PrometeoZgz/Nodo_ESP12/hardware_001/Listado componentes prometeo_001.ods

Sheet: Componentes_comunes
Part | Value | Device | Package | Description | MF | MPN | OC_FARNELL | OC_NEWARK
C1 | 100uF | CPOL-USSMCC | SMC_C | POLARIZED CAPACITOR, American symbol
C2 | 100nF | C-EUC0402 | C0402 | CAPACITOR, European symbol
C3 | 10uF | C-EUC0805 | C0805 | CAPACITOR, European symbol
C4 | 10uF | C-EUC0805 | C0805 | CAPACITOR, European symbol
C5 | 10uF | C-EUC0805 | C0805 | CAPACITOR, European symbol
C6 | 100nF | C-EUC0402 | C0402 | CAPACITOR, European symbol
C7 | 100uF | CPOL-USSMCC | SMC_C | POLARIZED CAPACITOR, American symbol
C8 | 100nF | C-EUC0402 | C0402 | CAPACITOR, European symbol
C9 | 10uF | C-EUC0805 | C0805 | CAPACITOR, European symbol
F1 |  | FUSE | FUSE | FUSE
IC2 | MAX11609 | MAX11609 | QSOP16 | 2.7V to 5.5V, Low-Power, 4-/12-Channel 2-Wire Serial 8-Bit ADCs
JP1 |  | PINHD-1X06_2.00 | 1X06M | PIN HEADER
JP2 |  | PINHD-1X2 | 1X02 | PIN HEADER
R1 | 470K | R-EU_R0402 | R0402 | RESISTOR, European symbol
R2 | 10K | R-EU_R0402 | R0402 | RESISTOR, European symbol
R3 | 10K | R-EU_R0402 | R0402 | RESISTOR, European symbol
R4 | 10K | R-EU_R0402 | R0402 | RESISTOR, European symbol
R5 | 10K | R-EU_R0402 | R0402 | RESISTOR, European symbol
R6 | 470K | R-EU_R0402 | R0402 | RESISTOR, European symbol
R7 | Por definir | R-EU_R0402 | R0402 | RESISTOR, European symbol
R8 | 470K | R-EU_R0402 | R0402 | RESISTOR, European symbol
R9 | 470K | R-EU_R0402 | R0402 | RESISTOR, European symbol
R10 | 470K | R-EU_R0402 | R0402 | RESISTOR, European symbol
R11 | 470K | R-EU_R0402 | R0402 | RESISTOR, European symbol
R12 | 18R | R-EU_R1206 | R1206 | RESISTOR, European symbol
R13 | 18R | R-EU_0204/7 | 0204/7 | RESISTOR, European symbol
R14 | Por definir | R-EU_R0402 | R0402 | RESISTOR, European symbol
R15 | 1K | R-EU_R0402 | R0402 | RESISTOR, European symbol
R17 | 1K | R-EU_R0402 | R0402 | RESISTOR, European symbol
R18 | 1K | R-EU_R0402 | R0402 | RESISTOR, European symbol
R19 | 470K | R-EU_R0402 | R0402 | RESISTOR, European symbol
R20 | 470K | R-EU_R0402 | R0402 | RESISTOR, European symbol
R21 | 18R | R-EU_R1206 | R1206 | RESISTOR, European symbol
R22 | 18R | R-EU_0204/7 | 0204/7 | RESISTOR, European symbol
R23 | 1K | R-EU_R0402 | R0402 | RESISTOR, European symbol
R24 | 470K | R-EU_R0402 | R0402 | RESISTOR, European symbol
R25 | 470K | R-EU_R0402 | R0402 | RESISTOR, European symbol
R26 | 18R | R-EU_R1206 | R1206 | RESISTOR, European symbol
R27 | 18R | R-EU_0204/7 | 0204/7 | RESISTOR, European symbol
R28 | 1K | R-EU_R0402 | R0402 | RESISTOR, European symbol
R29 | 1K | R-EU_R0402 | R0402 | RESISTOR, European symbol
R30 | 1K | R-EU_R0402 | R0402 | RESISTOR, European symbol
R31 | 210K | R-EU_R1206 | R1206 | RESISTOR, European symbol
R32 | 210K | R-EU_R1206 | R1206 | RESISTOR, European symbol
U$4 | KSR221GKSS221G_PACKAGE | KSR221GKSS221G_PACKAGE | SMD1 |  | C&K Components | KSR221G LFS | 1201421
U$6 | TRAFO_AISLAMIENTOBOURNS_SM-LP-5001 | TRAFO_AISLAMIENTOBOURNS_SM-LP-5001 | SM-LP-5001
U$7 | TRAFO_AISLAMIENTOETAL_P3191 | TRAFO_AISLAMIENTOETAL_P3191 | P3191
U1 | ESP12EPADS_SMD | ESP12EPADS_SMD | ESP12E_SMD
X1 | 1503_02 | 1503_02 | 1503_02 | Jack connectors according to JISC 6560, 3.5 mm |  |  | 1216979 | unknown
X2 | 1503_02 | 1503_02 | 1503_02 | Jack connectors according to JISC 6560, 3.5 mm |  |  | 1216979 | unknown
X3 | 1503_02 | 1503_02 | 1503_02 | Jack connectors according to JISC 6560, 3.5 mm |  |  | 1216979 | unknown
X4 | MKDSN1,5/2-5,08 | MKDSN1,5/2-5,08 | MKDSN1,5/2-5,08 | MKDSN 1,5/ 2-5,08 Printklemme
Entre U$6 y U$7 elegir sólo uno para montar
R7 y R14 se deberán fijar según pruebas
R12, R13, R21, R22, R26 y R27 deberán de ser de precisión a colocar según la pinza que se vaya a utilizar. Se han puesto dos huellas por resistencia, utilizar sólo una.
Tanto de las hojas marcadas como "A_" y "S_" se debe escoger una opción.
Las "A_" se refieren al tipo de alimentación a usar
Las "S_" se refieren a como alimentar la parte de los sensores.
Si se observan reseteos o funcionamientos extraños cuando el ESP está transmitiendo aumentar la capacidad de C7 a 470uF

Sheet: A_USB+batería
Part | Value | Device | Package | Description | MF | MPN | OC_FARNELL | OC_NEWARK
IC1 | STLQ015_SOT23-5L | STLQ015_SOT23-5L | SOT23-5L | ST => STLQ015XG33R
U$2 | DF13-3P-1.25H | DF13-3P-1.25H | DF13A-3P-1.25H | DF13-3P | Hirose | DF13-3P-1.25H
U$3 | MCP73811 | MCP73811 | SOT23-5L
U$10 | USBMICRO_USB_CONEXCON | USBMICRO_USB_CONEXCON | MICROUSB_CONEXCON_5632 | Conexcon => 5632-16052E | Conexcon | 5632-16052E

Sheet: A_Trafo_5V_+_batería
Part | Value | Device | Package | Description | MF | MPN | OC_FARNELL | OC_NEWARK
IC1 | STLQ015_SOT23-5L | STLQ015_SOT23-5L | SOT23-5L | ST => STLQ015XG33R
U$2 | DF13-3P-1.25H | DF13-3P-1.25H | DF13A-3P-1.25H | DF13-3P | Hirose | DF13-3P-1.25H
U$3 | MCP73811 | MCP73811 | SOT23-5L
U$5 | VTX-214-001-105 | PSU_VTX | PSU_VTX

Sheet: A_Trafo_3V3
Part | Value | Device | Package | Description | MF | MPN | OC_FARNELL | OC_NEWARK
U$5 | VTX-214-001-103 | PSU_VTX | PSU_VTX
Soldar el jumper SJ3

Sheet: S_Referencia_externa_3V3
Part | Value | Device | Package | Description | MF | MPN | OC_FARNELL | OC_NEWARK
Soldar SJ1 y SJ2.
El ADC deberá configurarse para utilizar la referencia externa

Sheet: S_Referencia_externa_3V
Part | Value | Device | Package | Description | MF | MPN | OC_FARNELL | OC_NEWARK
U$1 | MCP1501-30 | MCP1501 | SOT23-6
Soldar SJ1.
El ADC deberá configurarse para utilizar la referencia externa

Sheet: S_Referencia_interna
Part | Value | Device | Package | Description | MF | MPN | OC_FARNELL | OC_NEWARK
U$1 | MCP1501-20 | MCP1501 | SOT23-6
El ADC deberá configurarse para utilizar la referencia interna
