PrometeoZgz/Nodo_ESP12/hardware_002_plated/prometeo_002_plated_signals.pdf

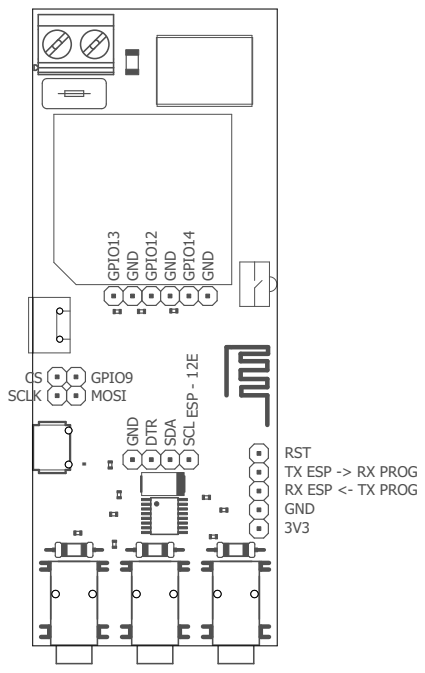
[picture p1: page 1]

ESP - 12E . 3V3 GND RST RX ESP <- TX PROG TX ESP -> RX PROG GND GND GND GPIO13 GPIO12 GPIO14 GND DTR SDA SCL GPIO9 MOSI CS SCLK
