PrometeoZgz/Nodo_ESP12/hardware_002_plated/prometeo_002_plated.brd

## EAGLE design hardware_002_plated/prometeo_002_plated.brd (2018-01-17)

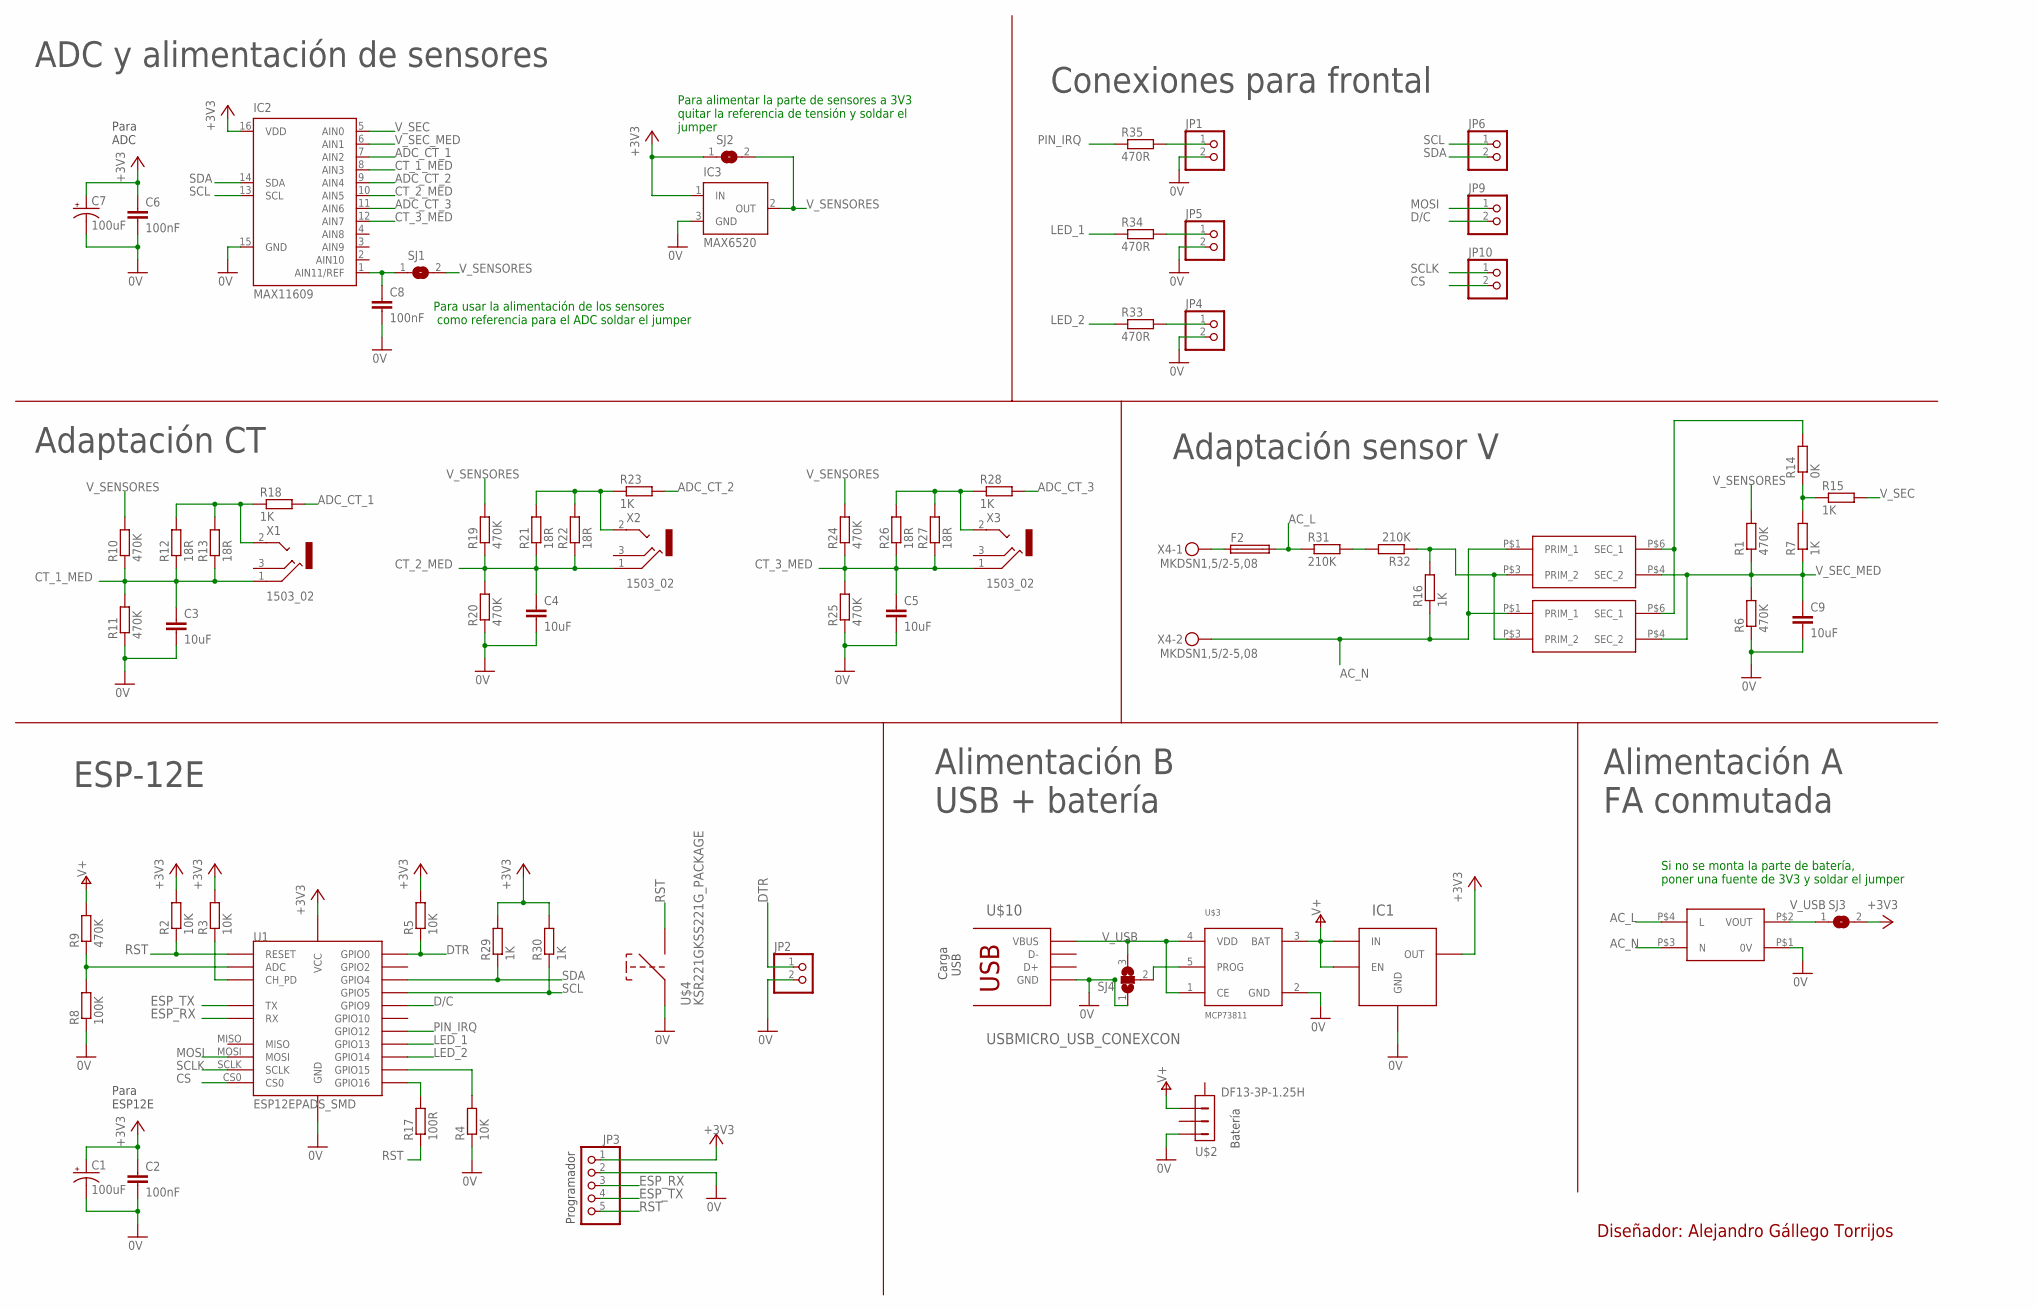
[picture p2: schematic prometeo_002_plated.sch]

Parts:
C1, C7: 100uF; SMC_C
C2, C6, C8: 100nF; C0402
C3, C4, C5, C9: 10uF; C0805
F2: MST 315MA 250V; TE5
IC1: STLQ015_SOT23-5L; SOT23-5L
IC2: MAX11609; QSOP16
IC3: MAX6520; SOT23
JP1, JP2, JP4, JP5, JP6, JP9, JP10: PINHD-1X2/CIRC; 1X02/CIRC
JP3: PINHD-1X5CIRC; 1X05/CIRC
R1, R6, R9, R10, R11, R19, R20, R24, R25: 470K; R0402
R2, R3, R4, R5: 10K; R0402
R7, R15, R18, R23, R28, R29, R30: 1K; R0402
R8: 100K; R0402
R12, R21, R26: 18R; R1206
R13, R22, R27: 18R; 0204/7
R14: 0K; R0402
R16: 1K; R1206
R17: 100R; R0402
R31, R32: 210K; R1206
R33, R34, R35: 470R; R0402
SJ1, SJ2, SJ3: SJ
SJ4: SJ2W; SJ_2
U1: ESP12EPADS_SMD; ESP12E_SMD
U$2: DF13-3P-1.25H; DF13A-3P-1.25H
U$3: MCP73811; SOT23-5L
U$4: KSR221GKSS221G_PACKAGE; SMD1
U$5: PSU_VTX
U$6: TRAFO_AISLAMIENTOBOURNS_SM-LP-5001; SM-LP-5001
U$7: TRAFO_AISLAMIENTOETAL_P3191; P3191
U$10: USBMICRO_USB_CONEXCON; MICROUSB_CONEXCON_5632
X1, X2, X3: 1503_02
X4: MKDSN1,5/2-5,08

Connections:
0V: C1.-, C2.2, C3.2, C4.2, C5.2, C6.2, C7.-, C8.2, C9.2, IC1.2 (GND), IC2.15 (GND), IC3.3 (GND), JP1.2, JP2.2, JP3.2, JP4.2, JP5.2, R4.1, R6.1, R8.1, R11.1, R20.1, R25.1, SJ4.1, U1.GND, U$2.P$1 (1), U$3.2 (GND), U$4.P$1, U$5.P$1 (0V), U$10.GND, U$10.GND1 (GND), U$10.GND2 (GND), U$10.P$8 (GND), U$10.P$9 (GND)
+3V3: C1.+, C2.1, C6.1, C7.+, IC1.5 (OUT), IC2.16 (VDD), IC3.1 (IN), JP3.1, R2.2, R3.2, R5.2, R29.2, R30.2, SJ2.1, SJ3.2, U1.VCC
AC_L: F2.2, R31.1, U$5.P$4 (L)
AC_N: R16.1, U$5.P$3 (N), U$6.P$1 (PRIM_1), U$7.P$1 (PRIM_1), X4.2
ADC_CT_1: IC2.7 (AIN2), R18.2
ADC_CT_2: IC2.9 (AIN4), R23.2
ADC_CT_3: IC2.11 (AIN6), R28.2
CS: JP10.2, U1.CS0
CT_1_MED: C3.1, IC2.8 (AIN3), R10.1, R11.2, R12.1, R13.1, X1.1
CT_2_MED: C4.1, IC2.10 (AIN5), R19.1, R20.2, R21.1, R22.1, X2.1
CT_3_MED: C5.1, IC2.12 (AIN7), R24.1, R25.2, R26.1, R27.1, X3.1
D/C: JP9.2, U1.GPIO9
DTR: JP2.1, R5.1, U1.GPIO0
ESP_RX: JP3.3, U1.RXD (RX)
ESP_TX: JP3.4, U1.TXD (TX)
LED_1: R34.1, U1.GPIO13
LED_2: R33.1, U1.GPIO14
MOSI: JP9.1, U1.MOSI
unnamed: R4.2, U1.GPIO15
unnamed: R16.2, R32.1, U$6.P$3 (PRIM_2), U$7.P$3 (PRIM_2)
unnamed: R3.1, U1.CH-PD (CH_PD)
unnamed: R31.2, R32.2
unnamed: R14.2, U$6.P$6 (SEC_1), U$7.P$6 (SEC_1)
unnamed: F2.1, X4.1
unnamed: R7.2, R14.1, R15.1
unnamed: SJ4.2, U$3.5 (PROG)
unnamed: JP1.1, R35.2
unnamed: R8.2, R9.1, U1.ADC
unnamed: R12.2, R13.2, R18.1, X1.2
unnamed: R17.2, U1.GPIO16
unnamed: JP4.1, R33.2
unnamed: R21.2, R22.2, R23.1, X2.2
unnamed: JP5.1, R34.2
unnamed: R26.2, R27.2, R28.1, X3.2
unnamed: C8.1, IC2.1 (AIN11/REF), SJ1.1
PIN_IRQ: R35.1, U1.GPIO12
RST: JP3.5, R2.1, R17.1, U1.RST (RESET), U$4.P$2
SCL: IC2.13 (SCL), JP6.1, R30.1, U1.GPIO5
SCLK: JP10.1, U1.SCLK
SDA: IC2.14 (SDA), JP6.2, R29.1, U1.GPIO4
V+: IC1.1 (IN), IC1.3 (EN), R9.2, U$2.P$3 (3), U$3.3 (BAT)
V_SEC: IC2.5 (AIN0), R15.2
V_SEC_MED: C9.1, IC2.6 (AIN1), R1.1, R6.2, R7.1, U$6.P$4 (SEC_2), U$7.P$4 (SEC_2)
V_SENSORES: IC3.2 (OUT), R1.2, R10.2, R19.2, R24.2, SJ1.2, SJ2.2
V_USB: SJ3.1, SJ4.3, U$3.1 (CE), U$3.4 (VDD), U$5.P$2 (VOUT), U$10.VBUS

Notes on the sheet:
Programador
Para ESP12E
ESP-12E
Carga USB
Batería
Alimentación B USB + batería
Alimentación A FA conmutada
Adaptación CT
Adaptación sensor V
Para ADC
Para alimentar la parte de sensores a 3V3 quitar la referencia de tensión y soldar el jumper
Para usar la alimentación de los sensores como referencia para el ADC soldar el jumper
Si no se monta la parte de batería, poner una fuente de 3V3 y soldar el jumper
Conexiones para frontal
Diseñador: Alejandro Gállego Torrijos
ADC y alimentación de sensores

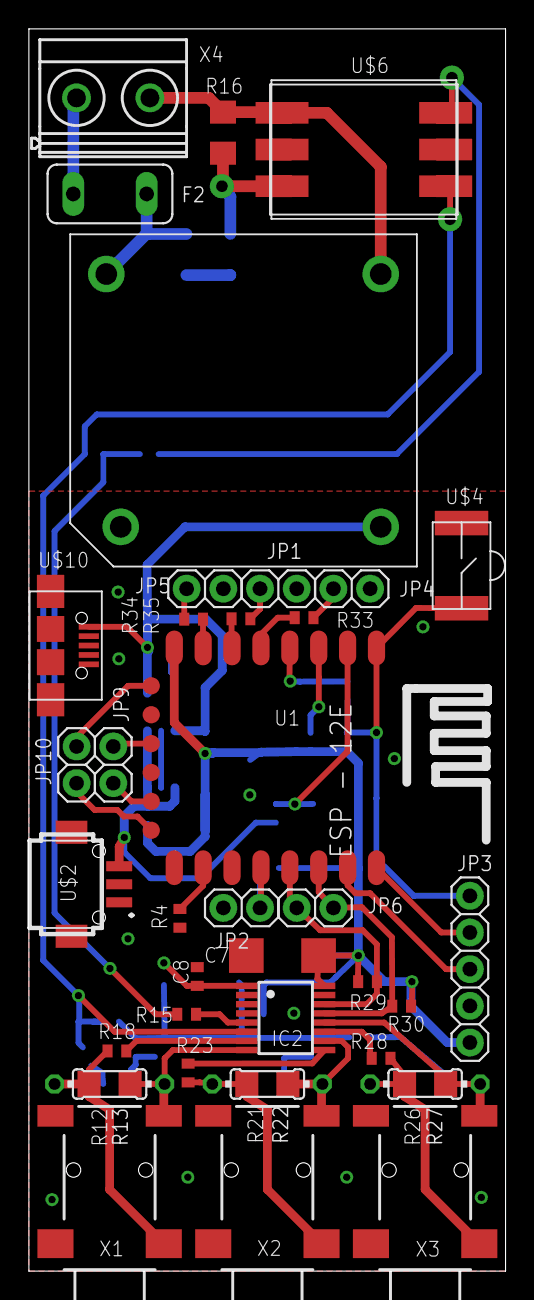
[picture p3: board prometeo_002_plated.brd from above]

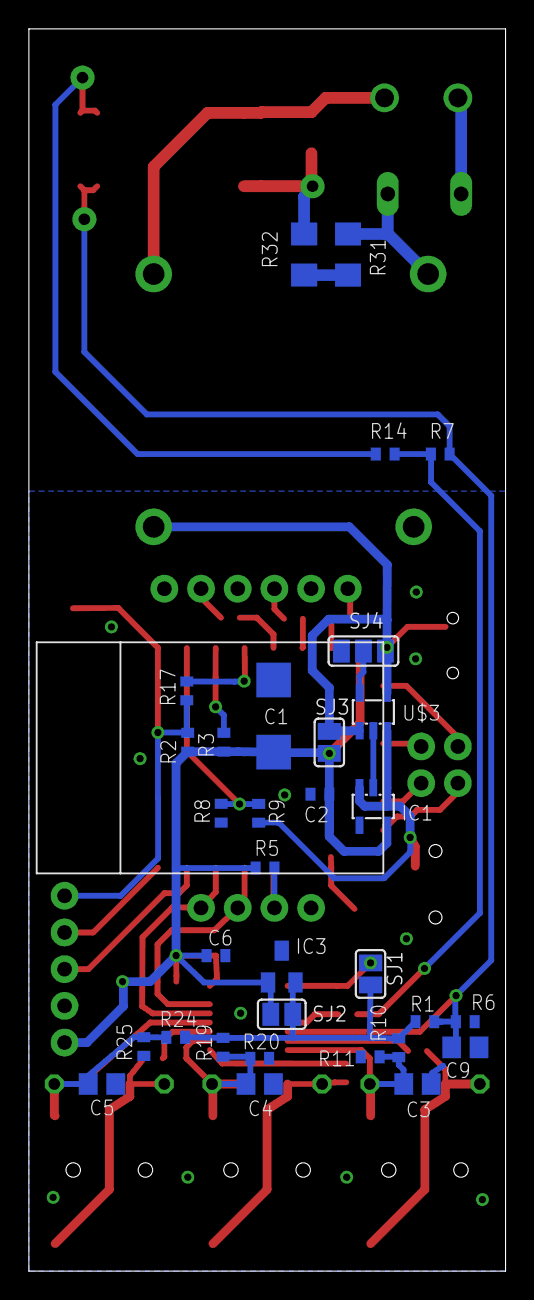
[picture p4: board prometeo_002_plated.brd from below]

Board: 2 copper layers, 33.0 x 86.0 mm, 72 parts (32 on the bottom side), 45 nets.
