PrometeoZgz/Nodo_ESP12/(commit log)

2017-10-24 First commit
    First commit adding the developed hardware.
    [Listado componentes prometeo_001.ods, prometeo_001.brd, prometeo_001.csv, prometeo_001.sch, prometeo_002_non_plated.brd, prometeo_002_non_plated.sch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]
2018-01-17 C7 position changed
    [prometeo_002_plated.brd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]
2018-02-27 Added a file with the signals of each pin
